Tybuu/choc/pcb/left/choc_keyboard.step

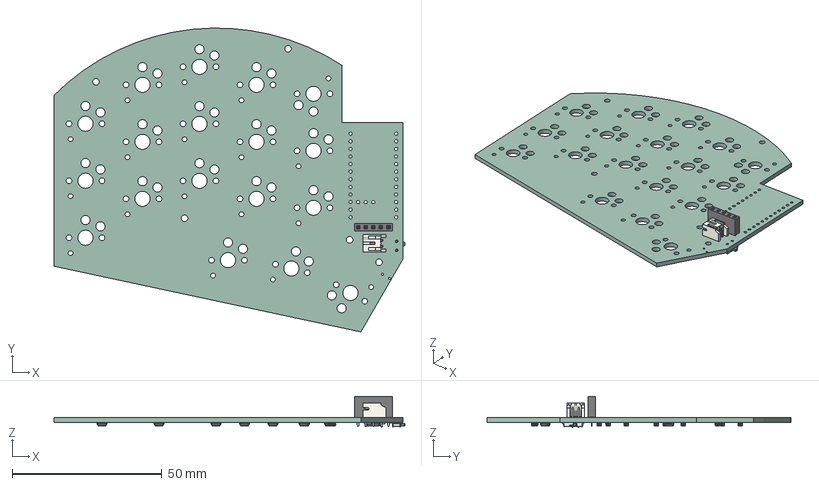
[picture p1: CAD file, 2025-01-08]
pcb/left/choc_keyboard.step
117.3 x 101.5 x 10.4 mm
JST_S2B_PH_K
PinSocket_1x05_P254mm_Vertical
D_SOD_123 x 18
R_0603_1608Metric x 2
Fusion_sp
TSSOP_8_44x3mm_P065mm
choc_keyboard_PCB
