Tybuu/choc/(list of files, cad)

Other CAD files:
pcb/right/choc_keyboard.step
