Tybuu/choc/pcb/right/choc_keyboard.kicad_pcb

## KiCad design pcb/right/choc_keyboard.kicad_pcb (2024-12-23)

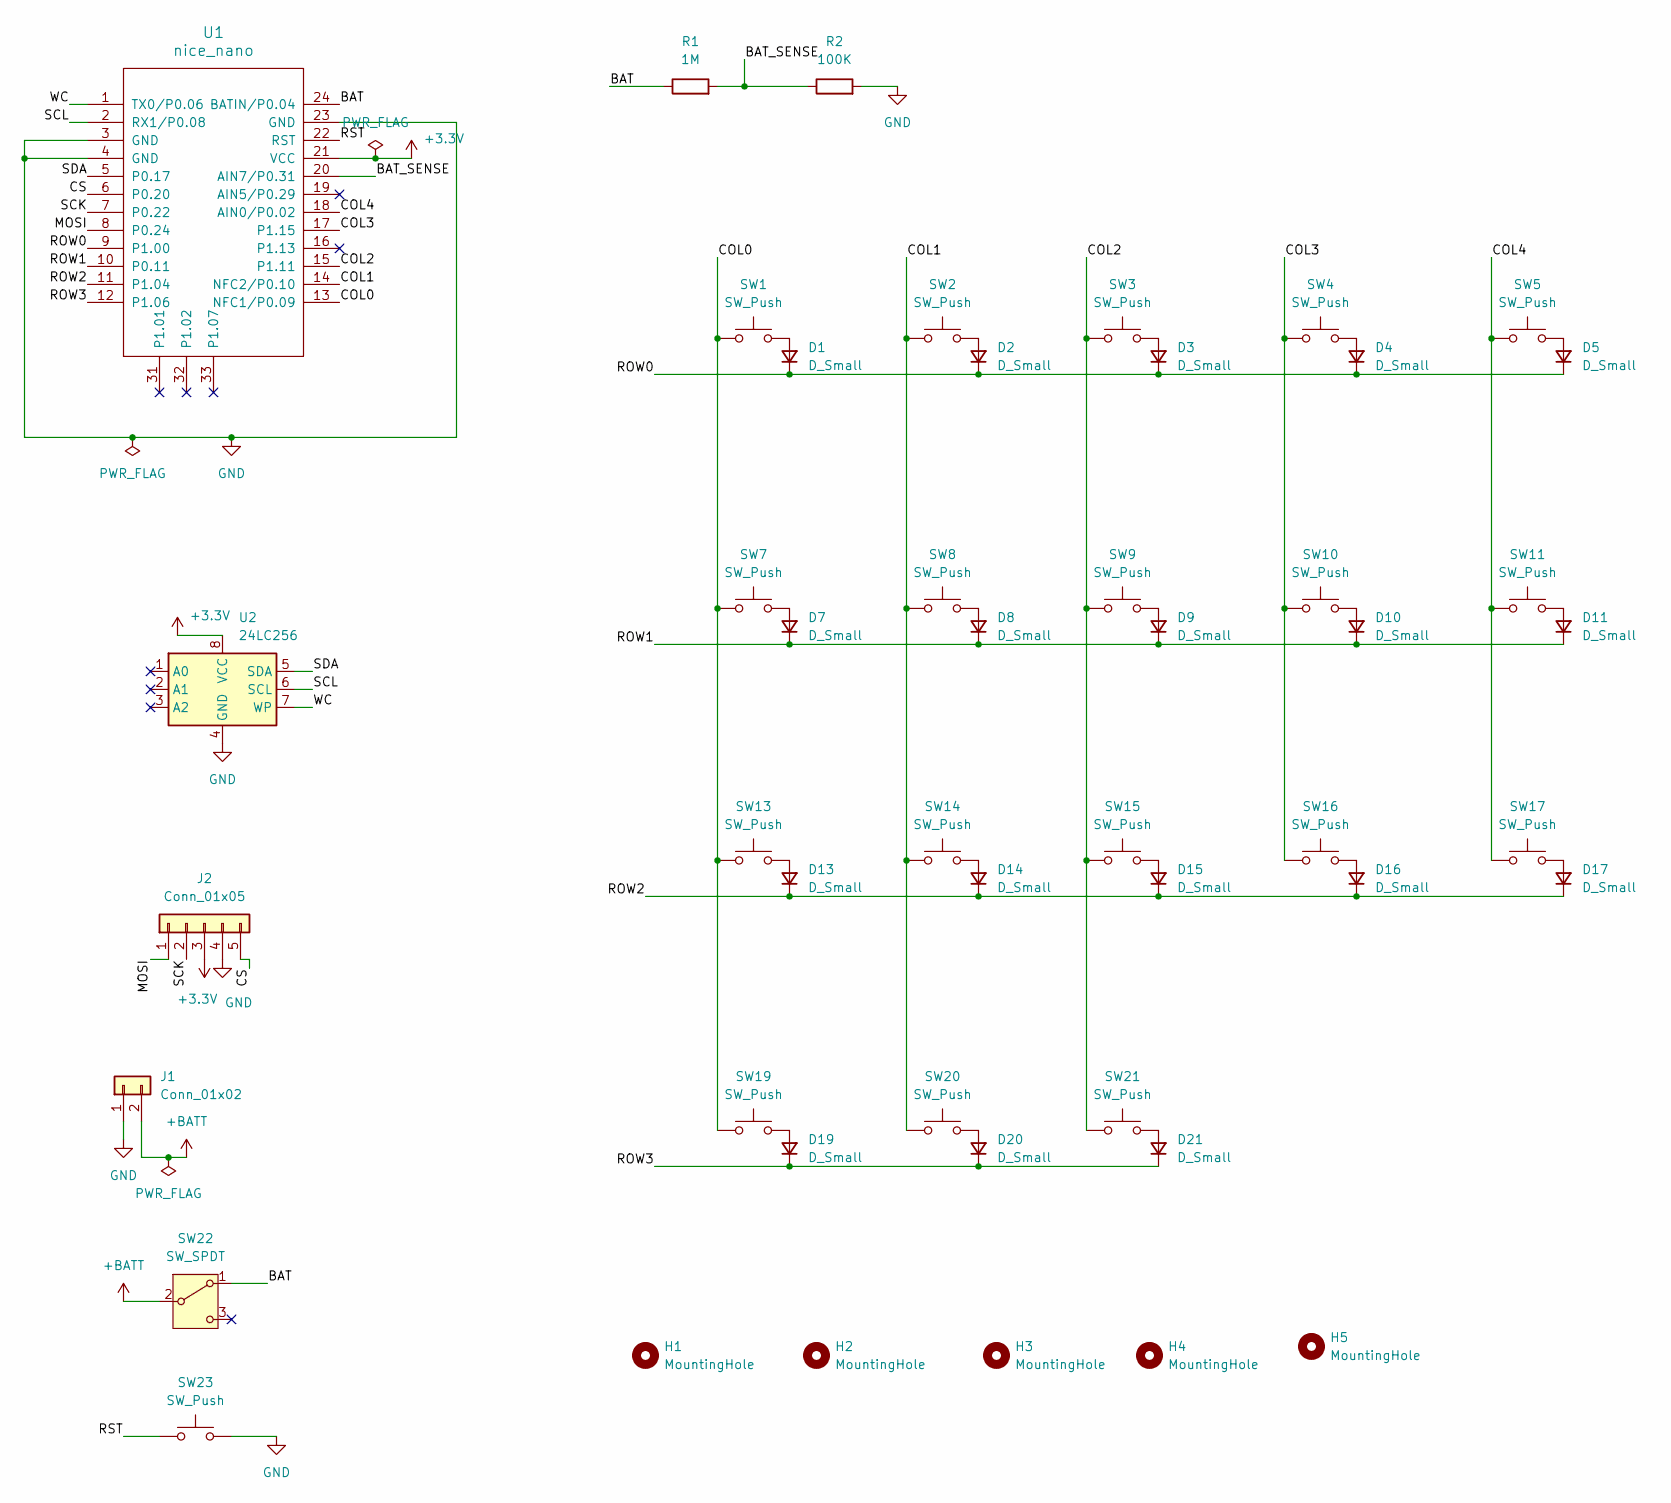
[picture p2: schematic choc_keyboard.kicad_sch]

Parts:
D1, D2, D3, D4, D5, D7, D8, D9, D10, D11, D13, D14, D15, D16, D17, D19, D20, D21: D_Small; D_SOD-123
H1, H2, H3, H4, H5: MountingHole; MountingHole_2.2mm_M2
J1: Conn_01x02; JST_PH_S2B-PH-K_1x02_P2.00mm_Horizontal
J2: Conn_01x05; PinSocket_1x05_P2.54mm_Vertical
R1: 1M; R_0603_1608Metric_Pad0.98x0.95mm_HandSolder
R2: 100K; R_0603_1608Metric_Pad0.98x0.95mm_HandSolder
SW1, SW2, SW3, SW4, SW5, SW7, SW8, SW9, SW10, SW11, SW13, SW14, SW15, SW16, SW17, SW19, SW20, SW21: SW_Push; SW_Hotswap_Kailh_Choc_V1V2_1.1
SW22: SW_SPDT; SW_SPDT_PCM12
SW23: SW_Push; Panasonic_EVQPUL_EVQPUC
U1: nice_nano
U2: 24LC256; TSSOP-8_4.4x3mm_P0.65mm

Connections:
+3.3V: J2.3, U1.21 (VCC), U2.8 (VCC)
+BATT: J1.2, SW22.2 (B)
/BAT: R1.1, SW22.1 (A), U1.24 (BATIN/P0.04)
/BAT_SENSE: R1.2, R2.1, U1.20 (AIN7/P0.31)
/COL0: SW1.1, SW7.1, SW13.1, SW19.1, U1.13 (NFC1/P0.09)
/COL1: SW2.1, SW8.1, SW14.1, SW20.1, U1.14 (NFC2/P0.10)
/COL2: SW3.1, SW9.1, SW15.1, SW21.1, U1.15 (P1.11)
/COL3: SW4.1, SW10.1, SW16.1, U1.17 (P1.15)
/COL4: SW5.1, SW11.1, SW17.1, U1.18 (AIN0/P0.02)
/CS: J2.5, U1.6 (P0.20)
/MOSI: J2.1, U1.8 (P0.24)
/ROW0: D1.1 (K), D2.1 (K), D3.1 (K), D4.1 (K), D5.1 (K), U1.9 (P1.00)
/ROW1: D7.1 (K), D8.1 (K), D9.1 (K), D10.1 (K), D11.1 (K), U1.10 (P0.11)
/ROW2: D13.1 (K), D14.1 (K), D15.1 (K), D16.1 (K), D17.1 (K), U1.11 (P1.04)
/ROW3: D19.1 (K), D20.1 (K), D21.1 (K), U1.12 (P1.06)
/RST: SW23.1, U1.22 (RST)
/SCK: J2.2, U1.7 (P0.22)
/SCL: U1.2 (RX1/P0.08), U2.6 (SCL)
/SDA: U1.5 (P0.17), U2.5 (SDA)
/WC: U1.1 (TX0/P0.06), U2.7 (WP)
GND: J1.1, J2.4, R2.2, SW23.2, U1.3 (GND), U1.4 (GND), U1.23 (GND), U2.4 (GND)
unnamed: D1.2 (A), SW1.2
unnamed: D2.2 (A), SW2.2
unnamed: D3.2 (A), SW3.2
unnamed: D4.2 (A), SW4.2
unnamed: D5.2 (A), SW5.2
unnamed: D7.2 (A), SW7.2
unnamed: D8.2 (A), SW8.2
unnamed: D9.2 (A), SW9.2
unnamed: D10.2 (A), SW10.2
unnamed: D11.2 (A), SW11.2
unnamed: D13.2 (A), SW13.2
unnamed: D14.2 (A), SW14.2
unnamed: D15.2 (A), SW15.2
unnamed: D16.2 (A), SW16.2
unnamed: D17.2 (A), SW17.2
unnamed: D19.2 (A), SW19.2
unnamed: D20.2 (A), SW20.2
unnamed: D21.2 (A), SW21.2

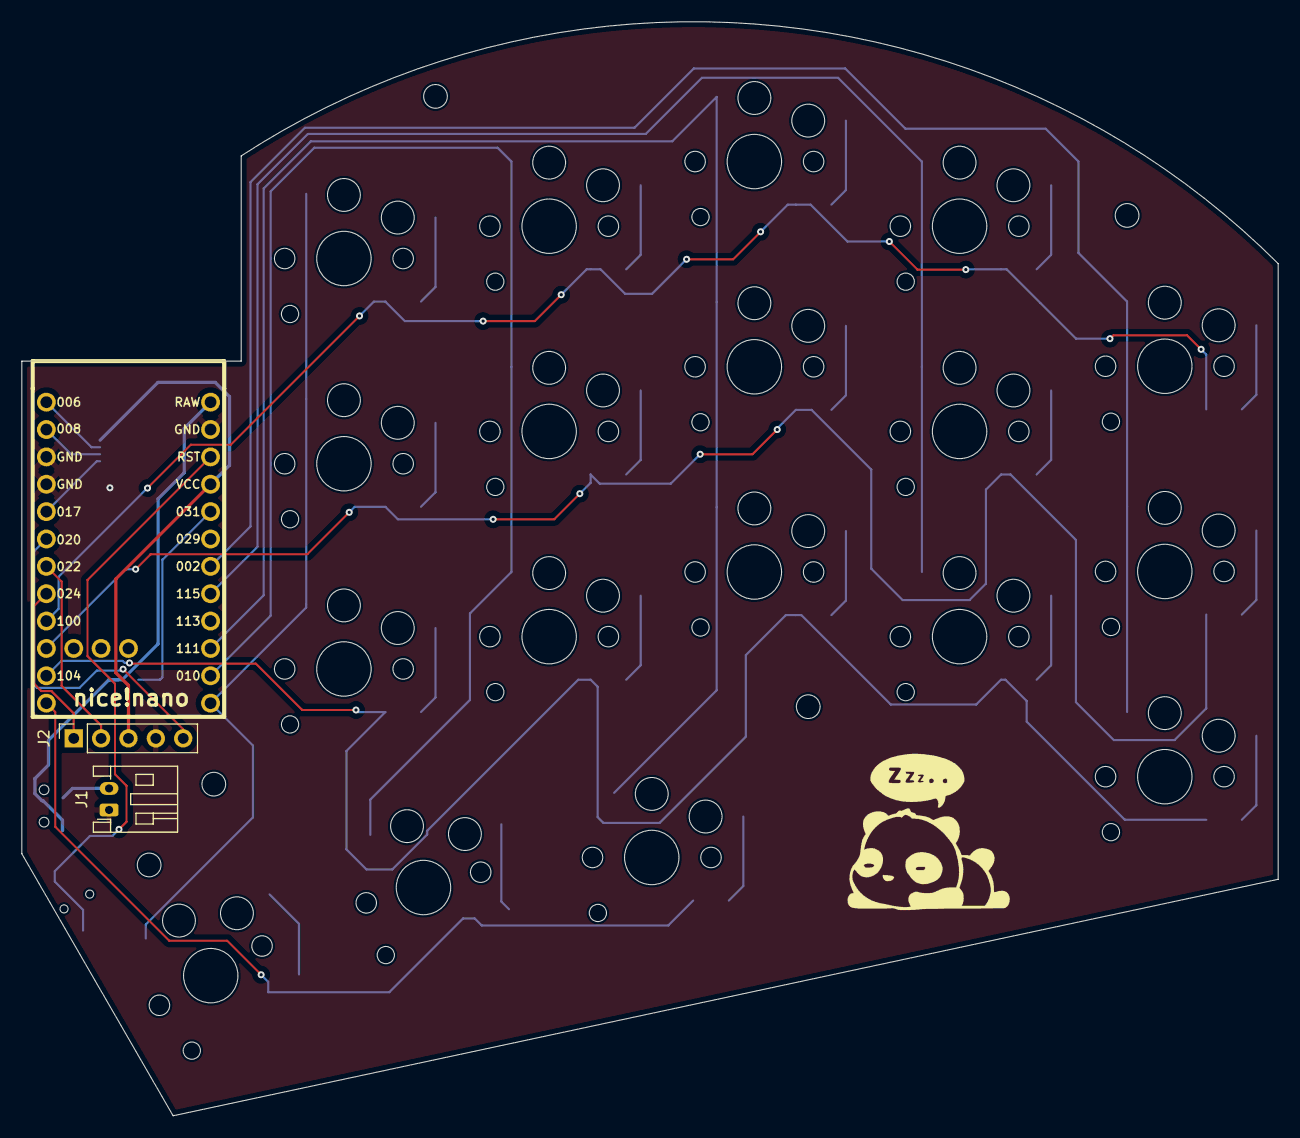
[picture p3: board choc_keyboard.kicad_pcb from above]

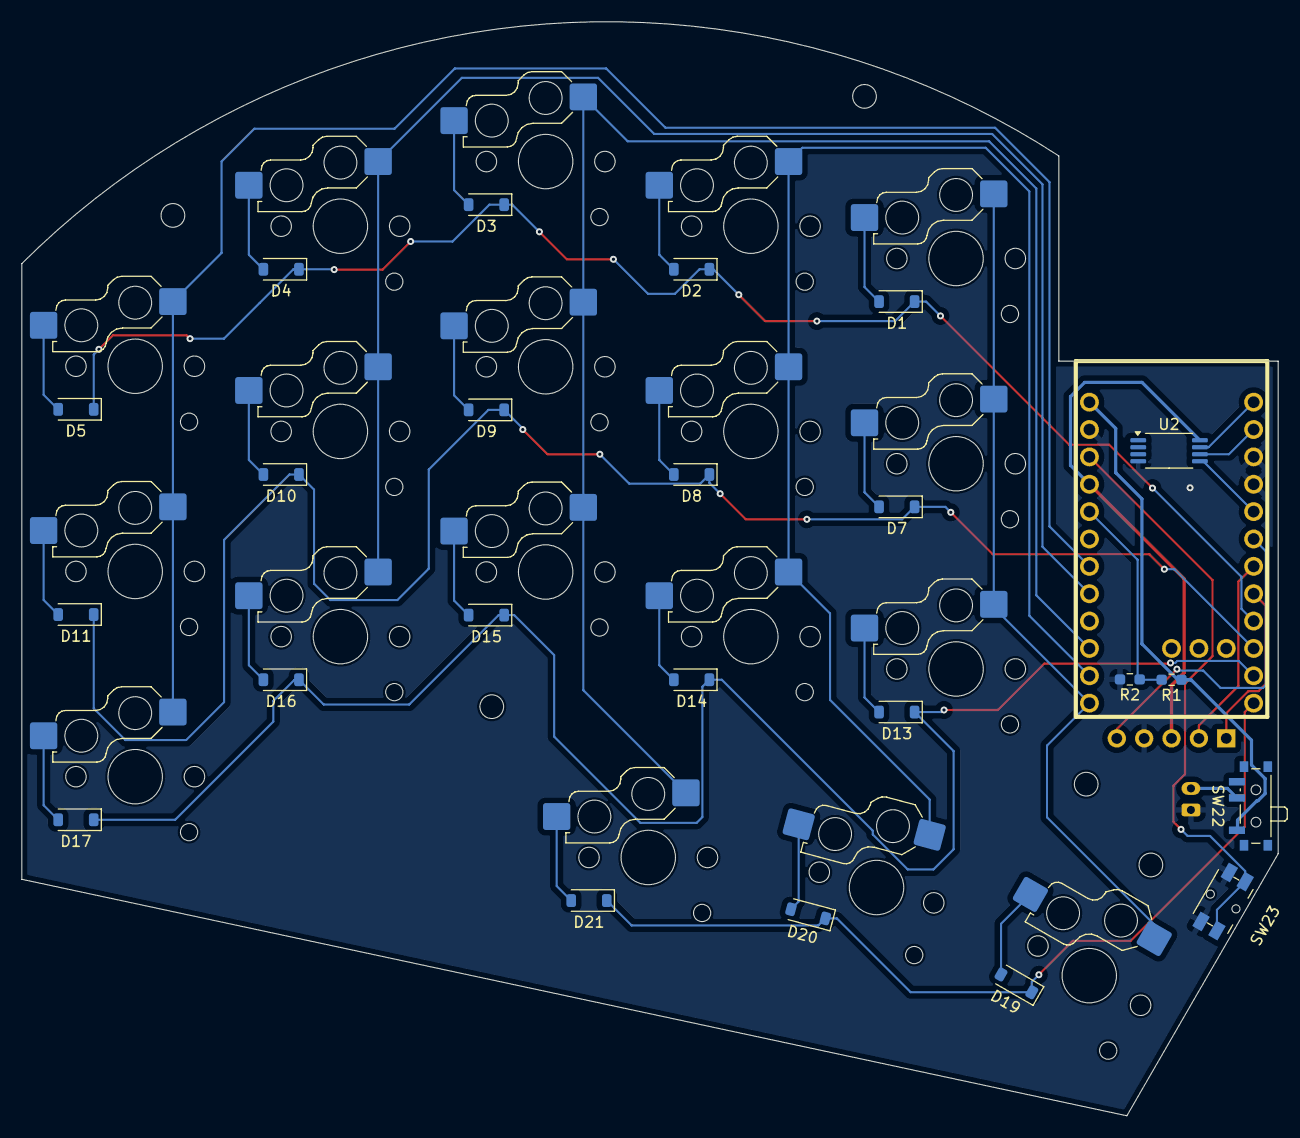
[picture p4: board choc_keyboard.kicad_pcb from below]

Board: 2 copper layers, 116.6 x 101.5 mm, 49 parts (23 on the bottom side), 39 nets.
