Tybuu/choc/(commit log)

2024-12-23 finished pcbs
    [bom.csv, choc_keyboard.kicad_pcb, choc_keyboard.kicad_sch, choc_keyboard.step, designators.csv, positions.csv]
2025-01-17 fixed matrix sleeping before debouncer stabalizes
    [l2_cen.rs, matrix.rs]
2025-01-18 switched to port interrupts from gpiote interrupts for matrix
